thementat/stages/datasheets/Stages.xlsx

Stages, 0805
Index | Qty | Description | Specs | Value | Package | New Mouser | References
SMT parts
R1, R2, R3, R4, R17, R18 | 6 | Resistor | <=1%, 100mW | 15k | 0805 | 603-RC0805FR-0715KL |  | 603-RC0805FR-0715KL|6
R5, R7, R8, R9, R10, R11 | 6 | Resistor | <=1%, 100mW | 100 | 0805 | 603-RC0805FR-07100RL |  | 603-RC0805FR-07100RL|6
R6, R12, R33, R60, R61, R62, R63, R64, R65 | 9 | Resistor | <=1%, 100mW | 10k | 0805 | 603-RC0805FR-0710KL |  | 603-RC0805FR-0710KL|9
R13, R14, R15, R16, R19, R20, R47, R49, R50, R51, R52, R53 | 12 | Resistor | <=1%, 100mW | 20k | 0805 | 603-RC0805FR-0720KL |  | 603-RC0805FR-0720KL|12
R21, R22, R23, R24, R26, R29 | 6 | Resistor | <=1%, 100mW | 30k | 0805 | 603-RC0805FR-0730KL |  | 603-RC0805FR-0730KL|6
R25, R27, R28, R30, R31, R32, R48, R66, R67, R68, R69, R70, R71, R72, R73, R74, R75, R76, R77 | 19 | Resistor | <=1%, 100mW | 100k | 0805 | 603-RC0805FR-07100KL |  | 603-RC0805FR-07100KL|19
R34, R35, R36, R37, R38, R39, R54, R55, R56, R57, R58, R59 | 12 | Resistor | <= 1%, >= 200mW | 1.0k | 0805 | 603-RC0805FR-071KL |  | 603-RC0805FR-071KL|12
R40, R41, R42, R43, R44, R45, R46 | 7 | Resistor | <=1%, 100mW | 130k | 0805 | 603-RC0805FR-07130KL |  | 603-RC0805FR-07130KL|7
L1, L2, L4, L5 | 4 | EMI Filter Bead | >= 1k ohm, 300mA |  | 0805 | 810-MMZ2012S102A | Würth Electronics 742792664 | 810-MMZ2012S102A|4
L3 | 1 | Inductor |  | 33u | 0805 | 810-MLZ2012M330WT000 | TDK MLZ2012M330WT000 | 810-MLZ2012M330WT000|1
C1, C2, C5, C6, C9, C10, C17, C19, C20, C21, C22, C23, C25 | 13 | Capacitor, ceramic | >= 25V, X5R | 22u | 1206 | 963-TMK316BBJ226ML-T | Murata GRM31CR61E226ME15L | 963-TMK316BBJ226ML-T|13
C3, C4 | 2 | Capacitor, ceramic | >=25V, C0G, <= 5% | 20p | 0805 | 603-CC805JRNPO9BN200 | Murata GRM1555C1E200JA01D | 603-CC805JRNPO9BN200|2
C7, C8, C11, C13, C14, C15, C16, C24, C30, C33, C34, C50, C51, C52, C53, C54, C55 | 17 | Capacitor, ceramic | >= 25V, X5R | 100n | 0805 | 581-08053D104KAT2A | Murata GRM155R61E104KA87D | 581-08053D104KAT2A|17
C12, C18, C26, C41, C43 | 5 | Capacitor, ceramic | >= 25V, X6S | 1u | 0805 | 81-GRM219C8YA105KA3D | Murata GRM155C81E105ME11D | 81-GRM219C8YA105KA3D|5
C27, C29, C31, C32, C35 | 5 | Capacitor, ceramic | >= 25V, X7R, <= 5% | 2.2n | 0805 | 603-CC805JRX7R9BB222 | Murata GRM155R71H222JA01J | 603-CC805JRX7R9BB222|5
C28 | 1 | Capacitor, ceramic | >= 25V, C0G, <= 5% | 470p | 0805 | 80-C0805C471J1GAUTO | Murata GRM1555C1E471JA01D | 80-C0805C471J1GAUTO|1
C36, C37, C38, C39, C40, C42 | 6 | Ceradiode |  |  | 0805 | 810-AVR-M2012C220K | Epcos / TDK B72500D160H60 | 810-AVR-M2012C220K|6
C44, C45, C46, C47, C48, C49 | 6 | Capacitor, ceramic | >= 25V, C0G, <= 5% | 100p | 0805 | 810-CGJ4C2C0G2A101J | Murata GRM1555C1H101JA01D | 810-CGJ4C2C0G2A101J|6
D1, D2 | 2 | 1N5819HW diode |  |  | SOD123 | 621-1N5819HW-F | Diodes Inc 1N5819HW-7-F | 621-1N5819HW-F|2
D3, D4, D5, D6, D7, D8 | 6 | 1N4148 silicon diode |  |  | SOD123 | 1N4148WQ-7-F | Fairchild Semi 1N4148WT | 1N4148WQ-7-F|6
D9 | 1 | BAT54S diode |  |  | SOT23 | 512-BAT54S | Fairchild BAT54S | 512-BAT54S|1
IC1 | 1 | TLC59281DBQ 16ch LED driver |  |  | TSSOP24 | 595-TLC59281DBQR | Texas Instruments TLC59281DBQR | 595-TLC59281DBQR|1
IC2 | 1 | ROF-78E3.3-0.5SMD-R 3.3V DC/DC converter |  |  | 12.5mm x 13.5mm | 919-ROF78E3.3-.5SMDR |  | 919-ROF78E3.3-.5SMDR|1
IC3, IC6 | 2 | CD4051 8-1 multiplexer |  |  | TSSOP16 | 595-CD4051BPWR |  | 595-CD4051BPWR|2
IC4 | 1 | DAC8168 octal DAC 14-bit |  |  | TSSOP14 | 595-DAC8168IAPW | Texas Instruments DAC8168IAPW | 595-DAC8168IAPW|1
IC5 | 1 | STM32F373RBT6, Cortex M4 128k flash |  |  | LQFP64 | 511-STM32F373RBT6 | ST STM32F373RBT6 | 511-STM32F373RBT6|1
IC7 | 1 | LD2981ABU33 LDO regulator | 3.3V |  | SOT89-3 | 511-LD2981ABU33 | ST LD2981ABU33TR | 511-LD2981ABU33|1
IC8, IC9, IC10 | 3 | MCP6002 dual op-amp R2R IO |  |  | MSOP8 | 579-MCP6002T-I/MS | Microchip MCP6002T-I/MS | 579-MCP6002T-I/MS|3
IC11 | 1 | LM4040 Shunt Vref | C Grade | 2.5V | SOT23 | 595-LM4040C25IDBZR | Texas Instruments LM4040C25IDBZ | 595-LM4040C25IDBZR|1
IC12, IC13, IC14 | 3 | TL074 Quad op-amp |  |  | TSSOP14 | 595-TL074CPWR |  | 595-TL074CPWR|3
Q1 | 1 | Crystal | <= 20ppm | 8MHz | 6mm x 3.6mm | 815-ABMM2-8-E2T | Abracon ABMM2-8.000MHZ-E2-T | 815-ABMM2-8-E2T|1
Q2, Q3, Q4, Q5, Q6, Q7 | 6 | NPN transistor MMBT3904 |  |  | SOT23 | 863-MMBT3904LT1G | On Semi MMBT3904LT1G | 863-MMBT3904LT1G|6
SMT parts (hand-soldered)
JP5 | 1 | 2x5 Header, 2.54 pitch
PTH parts, top side
JP3, JP4 | 2 | 1x3 male header, 2.54mm pitch
PTH parts, bottom side
J1, J2, J3, J4, J5, J6, J7, J8, J9, J10, J11, J12, J13, J14, J15, J16, J17, J18 | 18 | Vertical jack connector |  |  |  |  | https://www.thonk.co.uk/shop/thonkiconn/
LED1, LED2, LED3, LED4, LED5, LED6 | 6 | LED, Red/Green, 2 terminals |  |  | 2 terminals | 604-WP937EGW |  | 604-WP937EGW|6
- | 6 | LED holder, 10mm |  |  |  |  | Multicomp LED3-10
LED7, LED8, LED9, LED10, LED11, LED12 | 6 | LED 3mm red/green common anode |  |  |  | 696-SSLLX3059IGWCA | Lumex SSL-LX3059IGW-CA | 696-SSLLX3059IGWCA|6
- | 6 | LED holder, 0.3in |  |  |  | 749-ERM1-300 | Bivar ERM 1-300
R78, R79, R80, R81, R82, R83 | 6 | 20k linear slide pot, green LED |  |  |  | 652-PTL20-15G1-203B2 | Bourns PTL20-15G1-203B2 | 652-PTL20-15G1-203B2|6
R84, R85, R86, R87, R88, R89 | 6 | 10k linear pot, 25mm shaft with marker |  |  |  |  | https://www.thonk.co.uk/shop/ttpots/
SW1, SW2, SW3, SW4, SW5, SW6 | 6 | Switch, 6mm |  |  |  | 612-TL1105SP-250 | E-switch TL1105SPF250Q | 612-TL1105SP-250|6
- | 6 | Cap for switch |  |  |  | 612-1R-BK | E-switch 1RBLK | 612-1R-BK|6
PCB |  | 69.2 x 106.7
