thementat/stages/(list of files, cad)

Other CAD files:
pdf/stages_v70_panel.dwg
