thementat/stages/pdf/Schematic.pdf

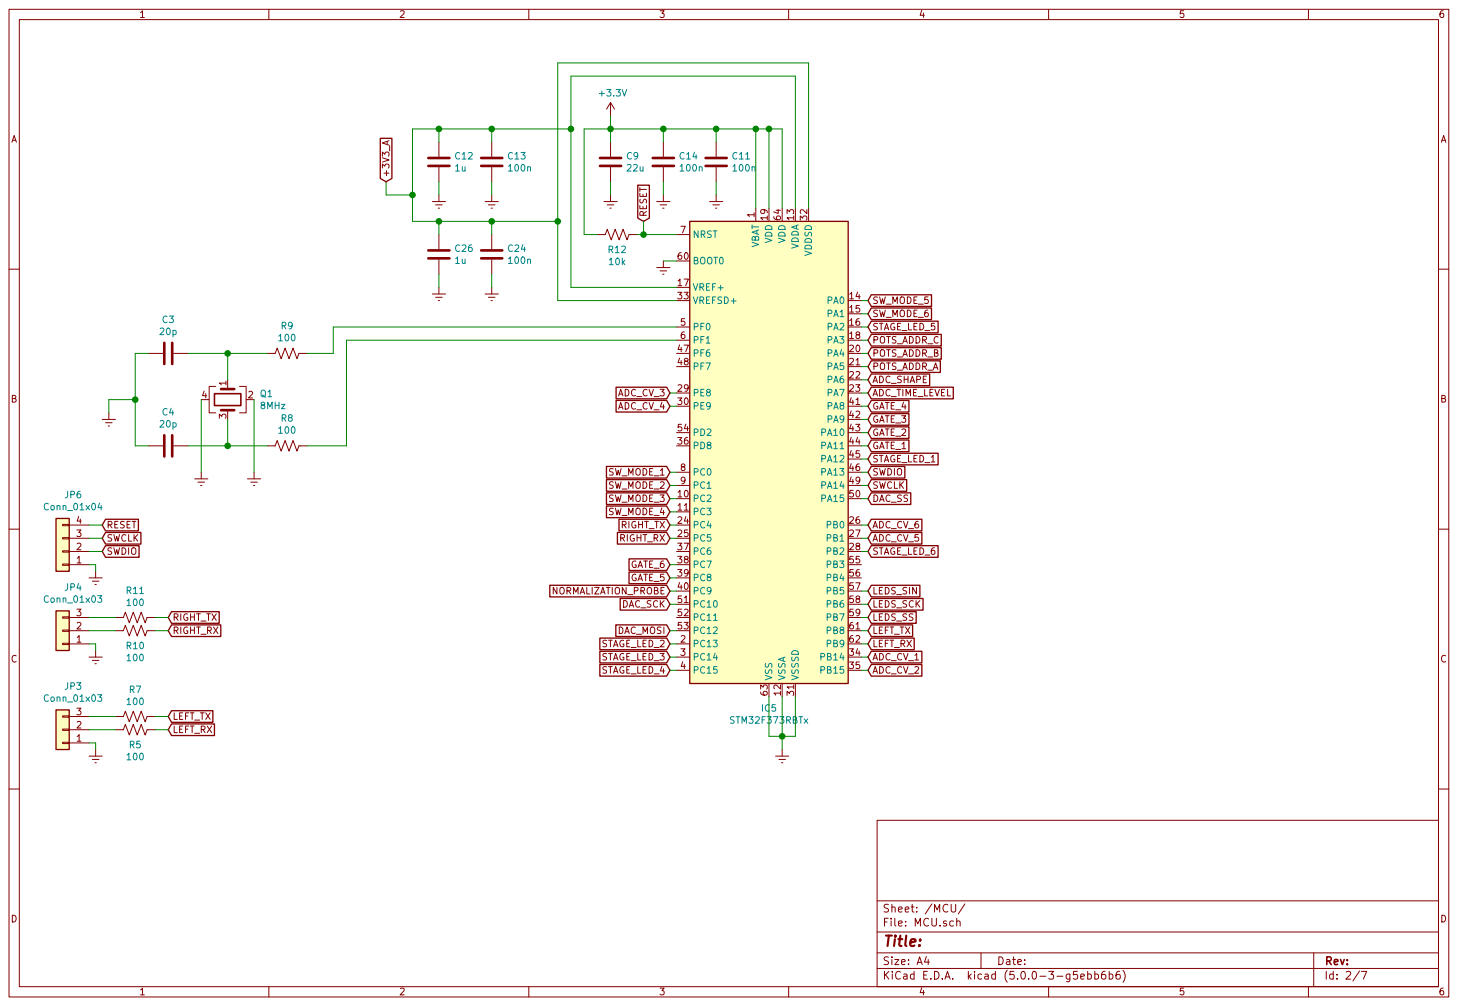
[picture p1: page 1]

Id: 2/7 Title: File: MCU.sch Sheet: /MCU/

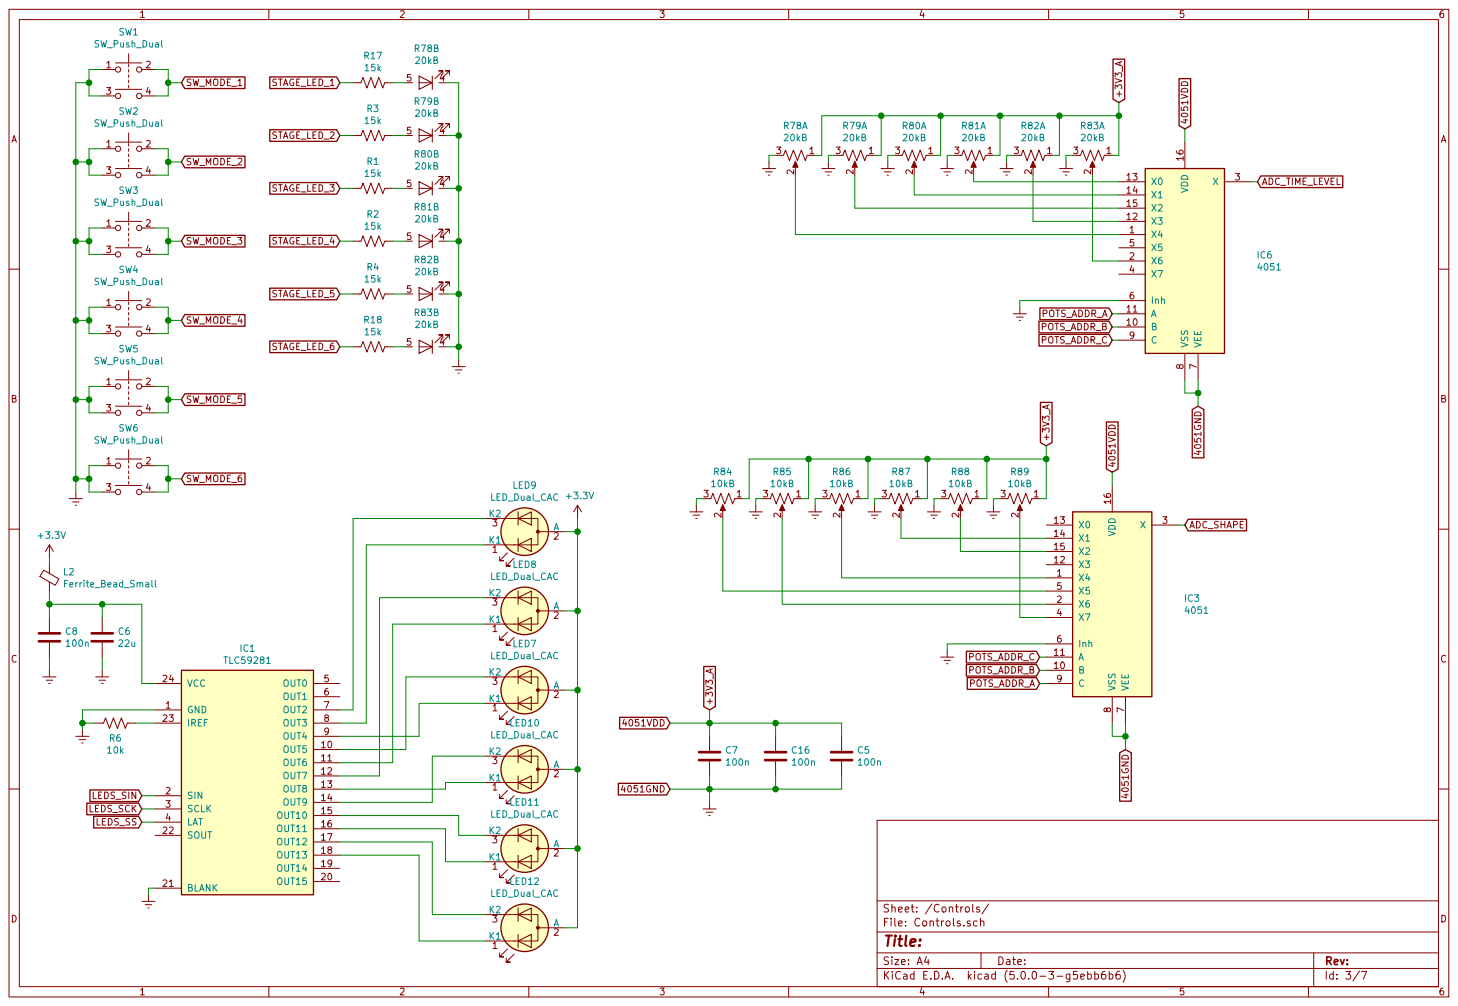
[picture p2: page 2]

Id: 3/7 Title: File: Controls.sch Sheet: /Controls/ 1 2 3 R78A

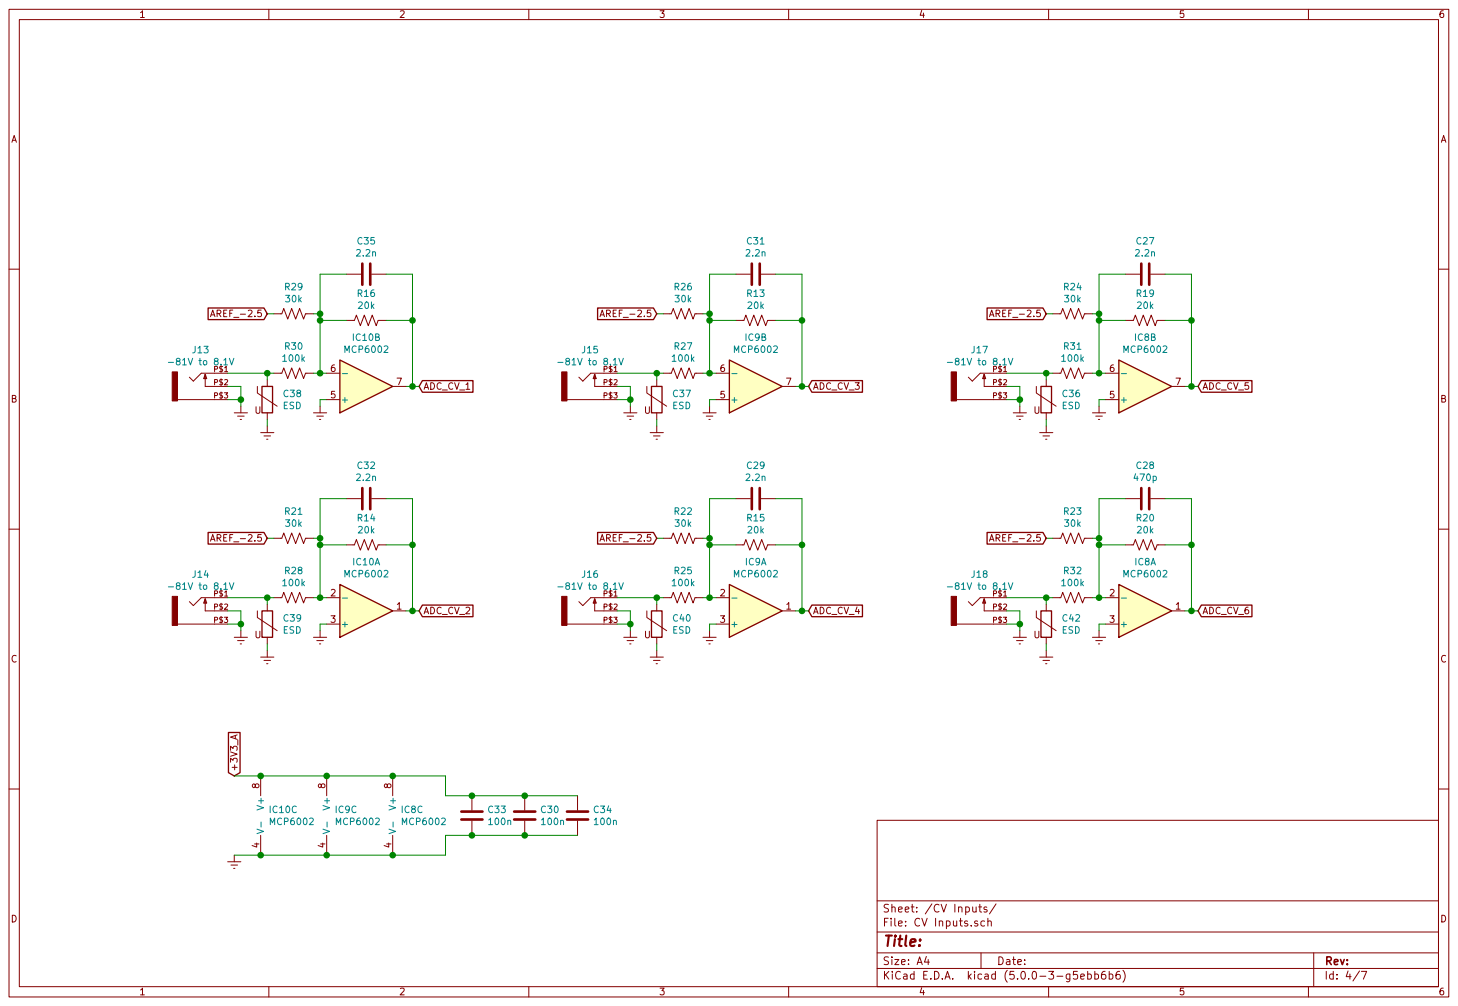
[picture p3: page 3]

File: CV Inputs.sch
Id: 4/7 Title:

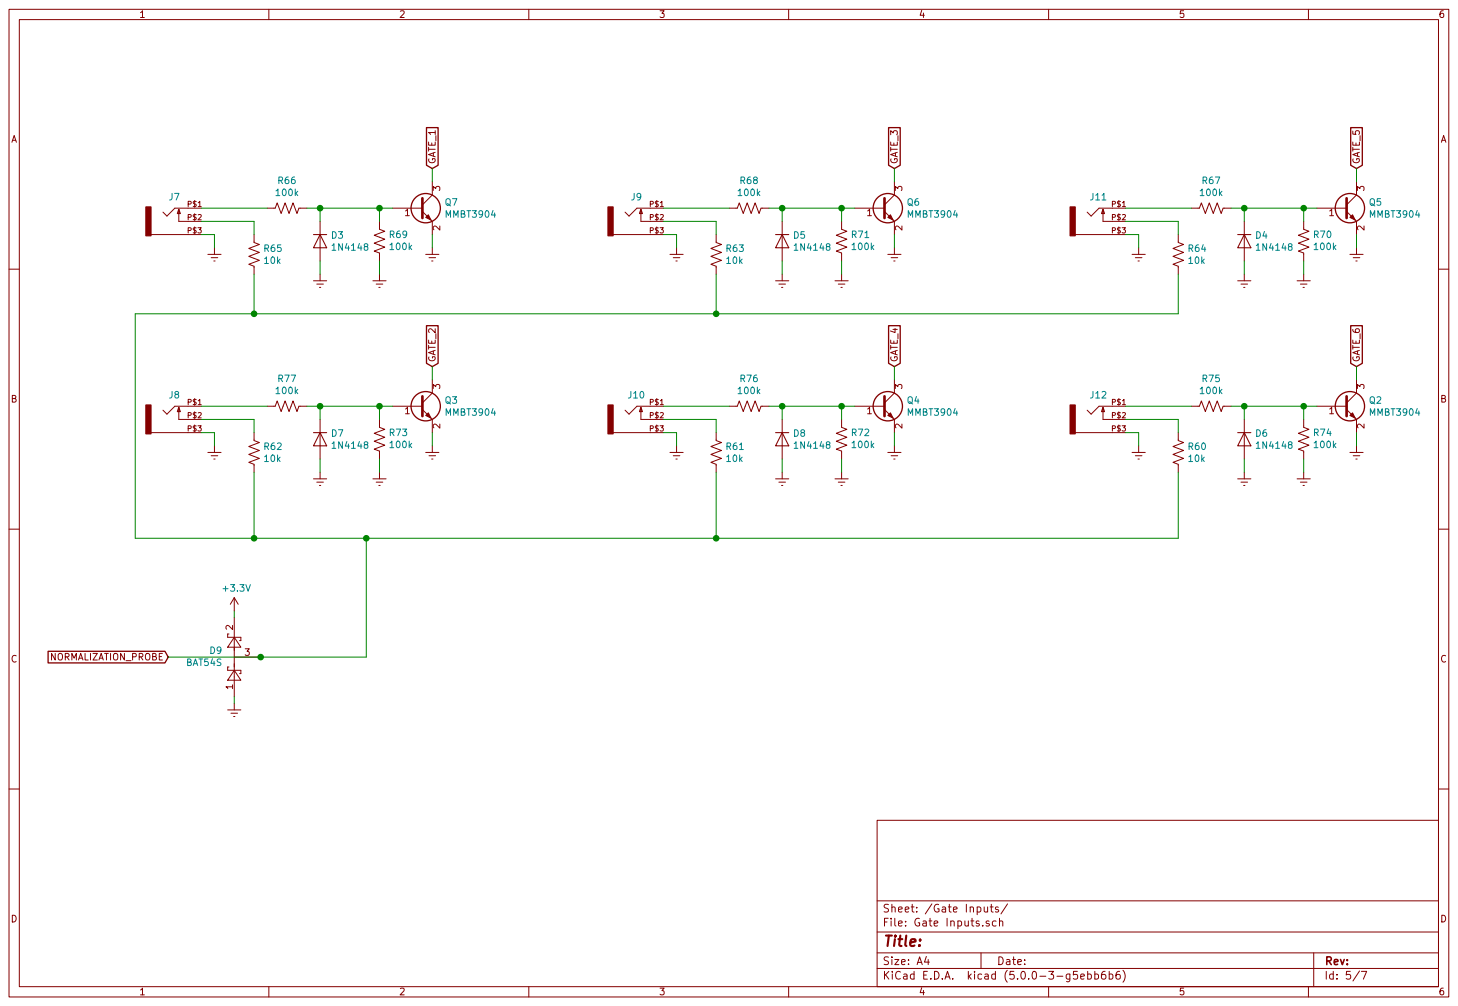
[picture p4: page 4]

Sheet: /Gate Inputs/
File: Gate Inputs.sch
Id: 5/7 Title:

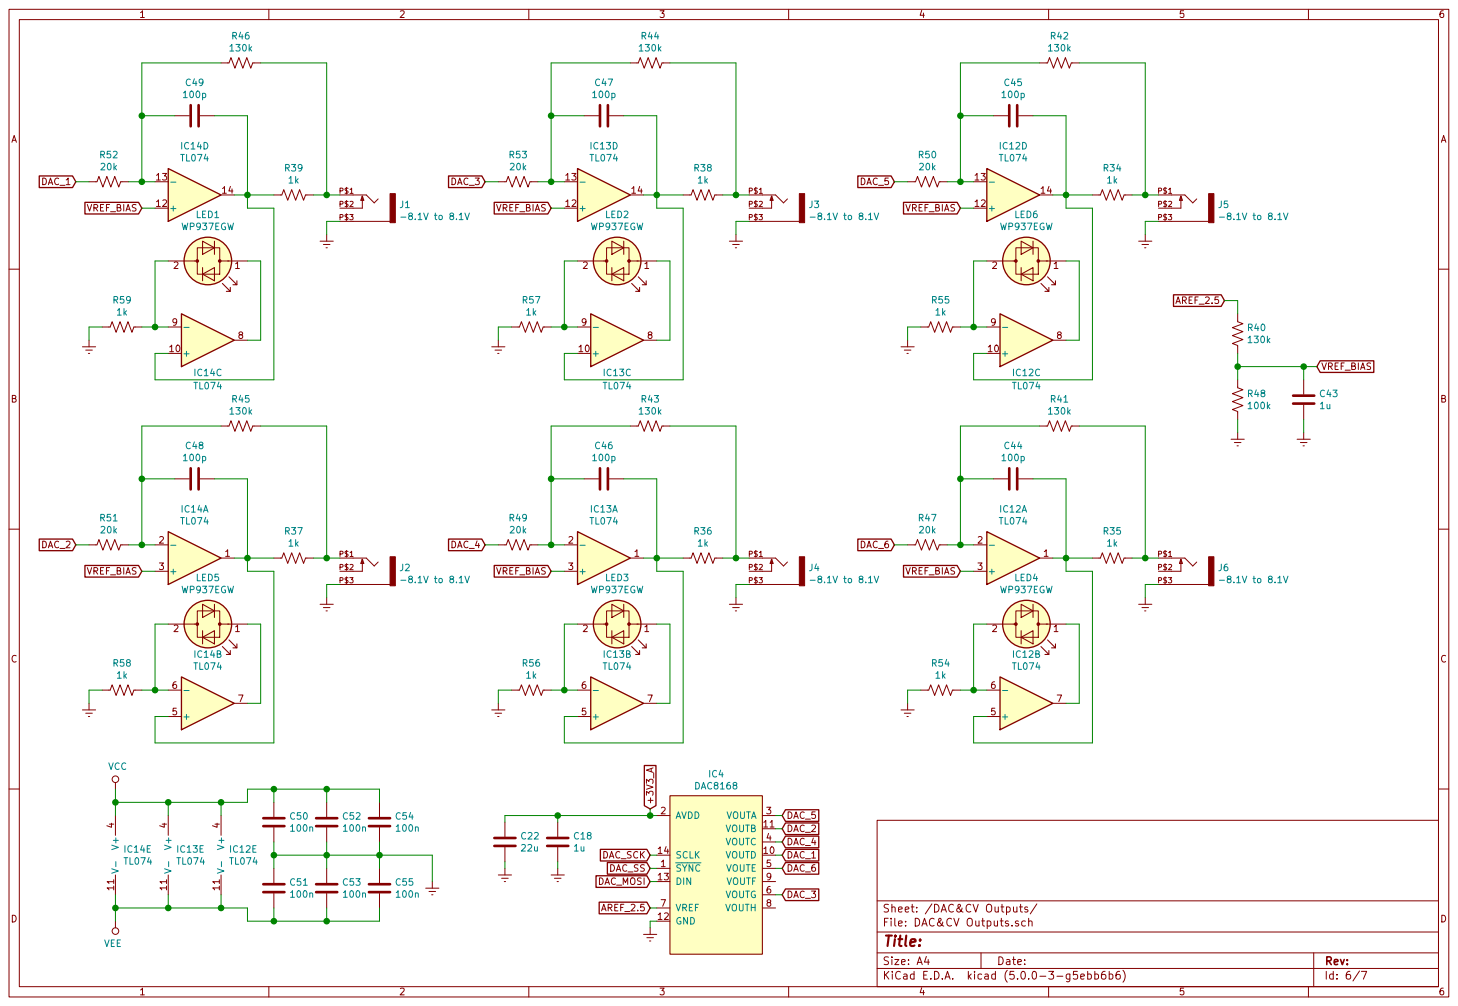
[picture p5: page 5]

Sheet: /DAC&CV Outputs/
File: DAC&CV Outputs.sch
Id: 6/7 Title:

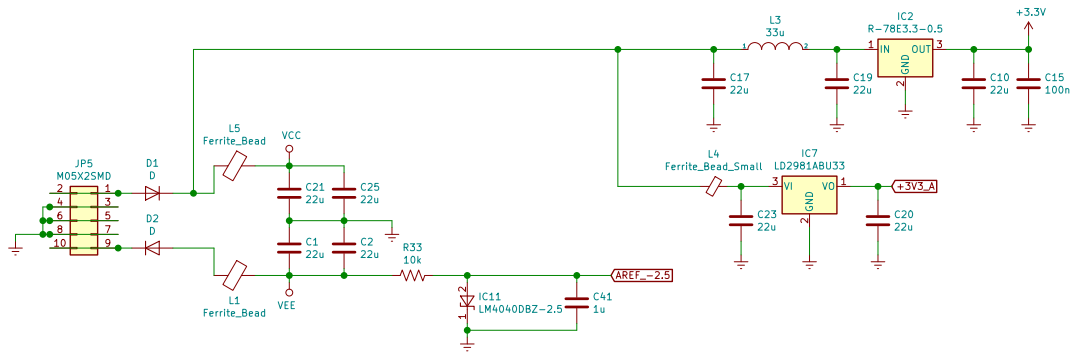
[picture p6: page 6]

Id: 7/7 Title: File: Power.sch Sheet: /Power/
