thementat/stages/pdf/Power-Power.pdf

Id: 7/7 Title: File: Power.sch Sheet: /Power/
