thementat/stages/pdf/Stages.pdf

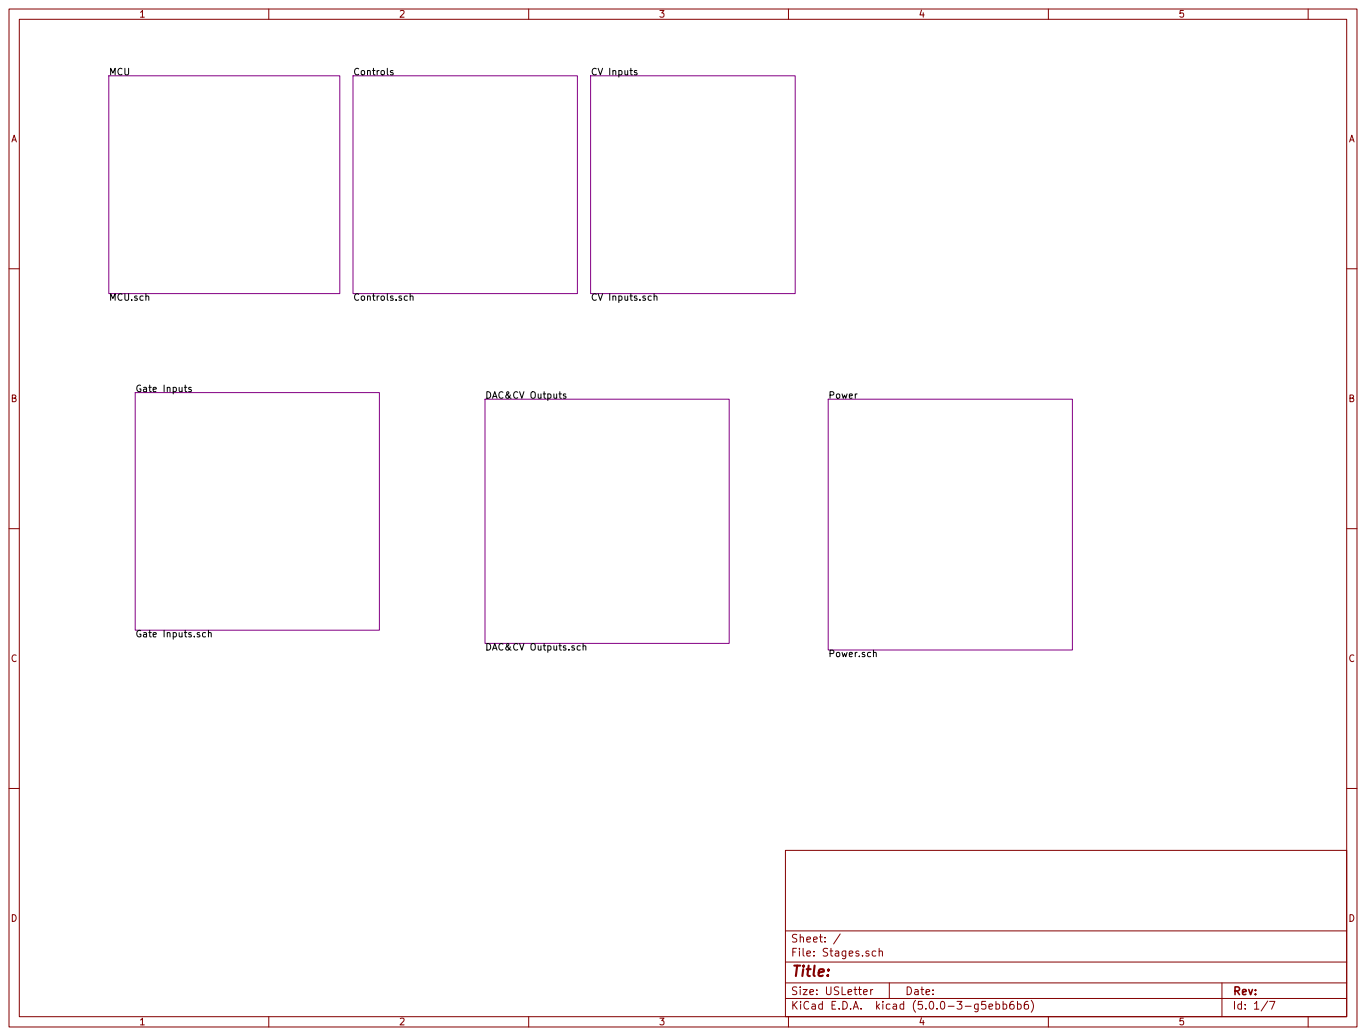
[picture p7: page 1]

File: Stages.sch Sheet: /


Id: 2/7 Title: File: MCU.sch Sheet: /MCU/


Id: 3/7 Title: File: Controls.sch Sheet: /Controls/ 1 2 3 R78A


File: CV Inputs.sch
Id: 4/7 Title:


Sheet: /Gate Inputs/
File: Gate Inputs.sch
Id: 5/7 Title:


Sheet: /DAC&CV Outputs/
File: DAC&CV Outputs.sch
Id: 6/7 Title:


Id: 7/7 Title: File: Power.sch Sheet: /Power/
