thementat/stages/pdf/stages_v70_panel.pdf

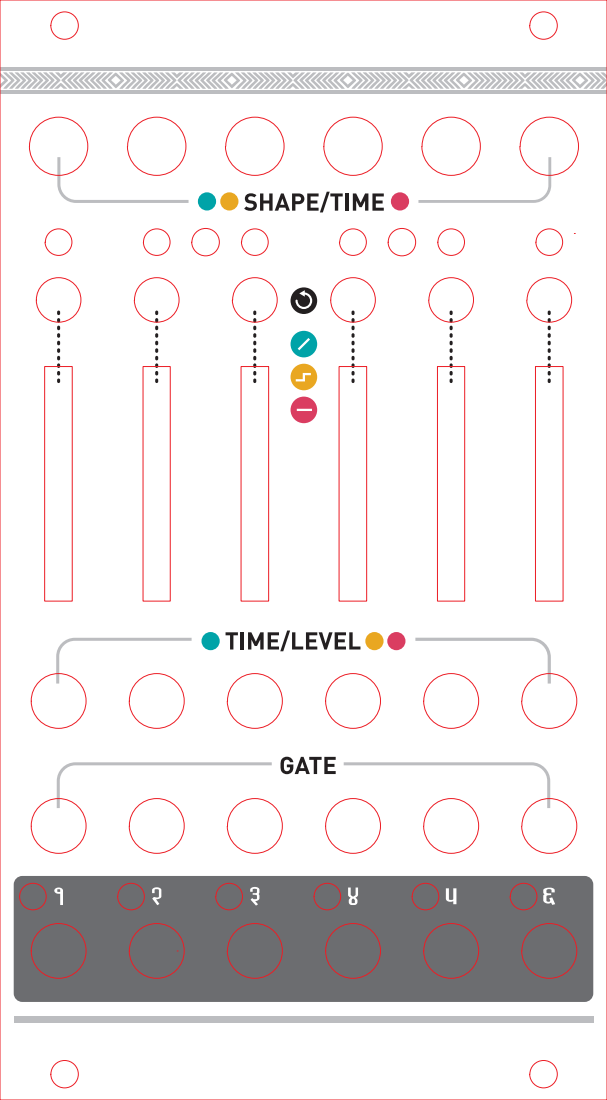
[picture p8: page 1]
