thementat/stages/pdf/Controls-Controls.pdf

Id: 3/7 Title: File: Controls.sch Sheet: /Controls/ 1 2 3 R78A
