thementat/stages/pdf/CV Inputs-CV Inputs.pdf

File: CV Inputs.sch
Id: 4/7 Title:
