thementat/stages/pdf/DAC&CV Outputs-DAC&CV Outputs.pdf

Sheet: /DAC&CV Outputs/
File: DAC&CV Outputs.sch
Id: 6/7 Title:
