thementat/stages/pdf/Gate Inputs-Gate Inputs.pdf

Sheet: /Gate Inputs/
File: Gate Inputs.sch
Id: 5/7 Title:
