thementat/stages/pdf/MCU-MCU.pdf

Id: 2/7 Title: File: MCU.sch Sheet: /MCU/
