thementat/stages/pdf/Panel Holes.pdf

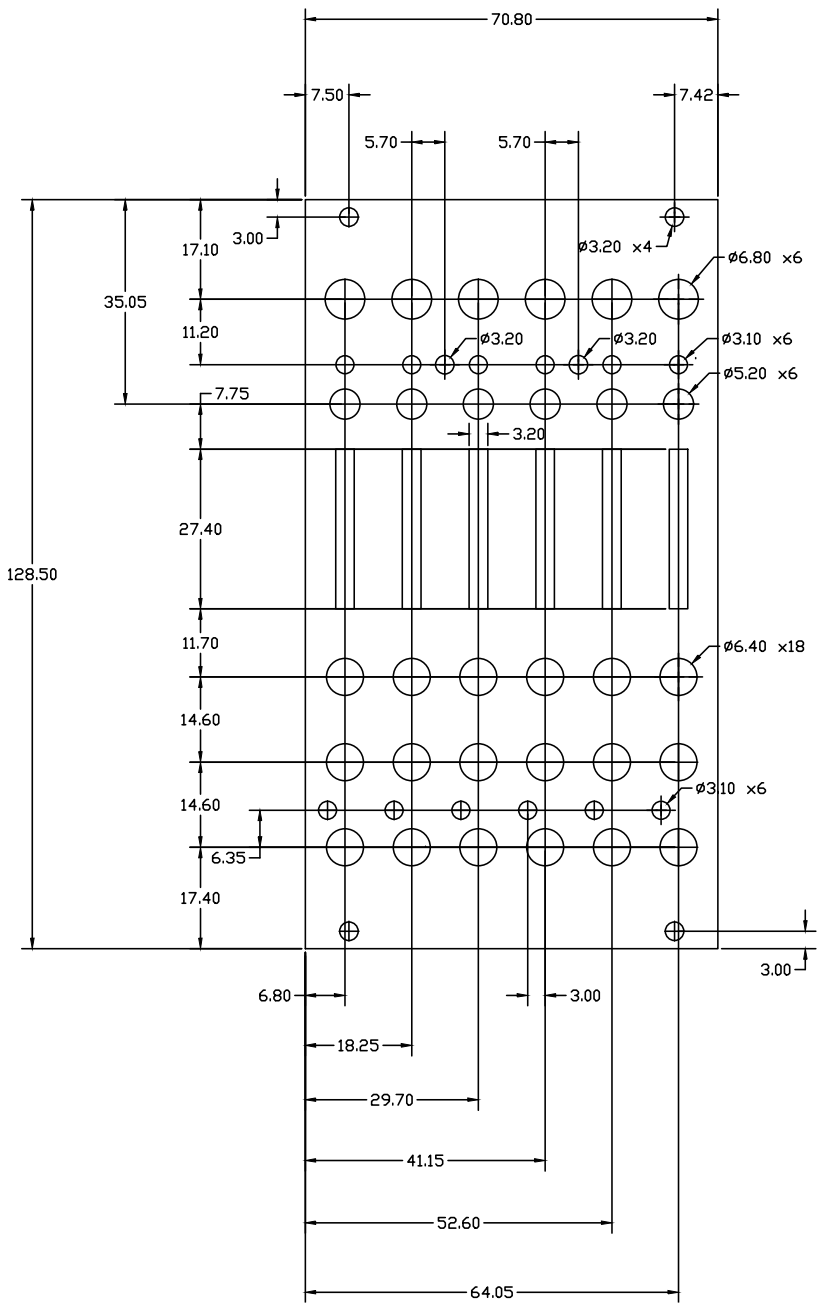
[picture p9: page 1]
