thementat/stages/Stages.kicad_pcb

## KiCad design Stages.kicad_pcb (2019-01-02)

Schematic: MCU.sch

Parts:
C3, C4: 20p; C_0805_2012Metric
C9: 22u; C_1206_3216Metric
C11, C13, C14, C24: 100n; C_0805_2012Metric
C12, C26: 1u; C_0805_2012Metric
IC5: STM32F373RBTx; LQFP-64_10x10mm_P0.5mm
JP3, JP4: Conn_01x03; PinHeader_1x03_P2.54mm_Vertical
JP6: Conn_01x04; PinHeader_1x04_P2.54mm_Vertical
Q1: 8MHz; Crystal_SMD_Abracon_ABMM2-4Pin_6.0x3.6mm_HandSoldering
R5, R7, R8, R9, R10, R11: 100; R_0805_2012Metric
R12: 10k; R_0805_2012Metric

Connections:
+3V3: C9.1, C11.1, C14.1, IC5.1 (VBAT), IC5.19 (VDD), IC5.64 (VDD), R12.2; also elsewhere on the board
+3V3_A: C12.1, C13.1, C24.1, C26.1, IC5.13 (VDDA), IC5.17 (VREF+), IC5.32 (VDDSD), IC5.33 (VREFSD+); also elsewhere on the board
ADC_CV_1: IC5.34 (PB14); also elsewhere on the board
ADC_CV_2: IC5.35 (PB15); also elsewhere on the board
ADC_CV_3: IC5.29 (PE8); also elsewhere on the board
ADC_CV_4: IC5.30 (PE9); also elsewhere on the board
ADC_CV_5: IC5.27 (PB1); also elsewhere on the board
ADC_CV_6: IC5.26 (PB0); also elsewhere on the board
ADC_SHAPE: IC5.22 (PA6); also elsewhere on the board
ADC_TIME_LEVEL: IC5.23 (PA7); also elsewhere on the board
DAC_MOSI: IC5.53 (PC12); also elsewhere on the board
DAC_SCK: IC5.51 (PC10); also elsewhere on the board
DAC_SS: IC5.50 (PA15); also elsewhere on the board
GATE_1: IC5.44 (PA11); also elsewhere on the board
GATE_2: IC5.43 (PA10); also elsewhere on the board
GATE_3: IC5.42 (PA9); also elsewhere on the board
GATE_4: IC5.41 (PA8); also elsewhere on the board
GATE_5: IC5.39 (PC8); also elsewhere on the board
GATE_6: IC5.38 (PC7); also elsewhere on the board
LEDS_SCK: IC5.58 (PB6); also elsewhere on the board
LEDS_SIN: IC5.57 (PB5); also elsewhere on the board
LEDS_SS: IC5.59 (PB7); also elsewhere on the board
LEFT_RX: IC5.62 (PB9), R7.1
LEFT_TX: IC5.61 (PB8), R5.1
NORMALIZATION_PROBE: IC5.40 (PC9); also elsewhere on the board
unnamed: C3.2, Q1.1, R9.1
unnamed: C4.2, Q1.3, R8.1
unnamed: IC5.5 (PF0), R9.2
unnamed: IC5.6 (PF1), R8.2
unnamed: JP3.2, R5.2
unnamed: JP3.3, R7.2
unnamed: JP4.2, R10.2
unnamed: JP4.3, R11.2
POTS_ADDR_A: IC5.21 (PA5); also elsewhere on the board
POTS_ADDR_B: IC5.20 (PA4); also elsewhere on the board
POTS_ADDR_C: IC5.18 (PA3); also elsewhere on the board
RESET: IC5.7 (NRST), JP6.4, R12.1
RIGHT_RX: IC5.25 (PC5), R10.1
RIGHT_TX: IC5.24 (PC4), R11.1
STAGE_LED_1: IC5.45 (PA12); also elsewhere on the board
STAGE_LED_2: IC5.2 (PC13); also elsewhere on the board
STAGE_LED_3: IC5.3 (PC14); also elsewhere on the board
STAGE_LED_4: IC5.4 (PC15); also elsewhere on the board
STAGE_LED_5: IC5.16 (PA2); also elsewhere on the board
STAGE_LED_6: IC5.28 (PB2); also elsewhere on the board
SWCLK: IC5.49 (PA14), JP6.3
SWDIO: IC5.46 (PA13), JP6.2
SW_MODE_1: IC5.8 (PC0); also elsewhere on the board
SW_MODE_2: IC5.9 (PC1); also elsewhere on the board
SW_MODE_3: IC5.10 (PC2); also elsewhere on the board
SW_MODE_4: IC5.11 (PC3); also elsewhere on the board
SW_MODE_5: IC5.14 (PA0); also elsewhere on the board
SW_MODE_6: IC5.15 (PA1); also elsewhere on the board

Schematic: Controls.sch

Parts:
C5, C7, C8, C16: 100n; C_0805_2012Metric
C6: 22u; C_1206_3216Metric
IC1: TLC59281; TSSOP-24_4.4x7.8mm_P0.65mm
IC3, IC6: 4051; TSSOP-16_4.4x5mm_P0.65mm
L2: Ferrite_Bead_Small; R_0805_2012Metric
LED7, LED8, LED9, LED10, LED11, LED12: LED_Dual_CAC; LED_3.0mm Bi-Color Common Anode
MH1, MH2, MH3: MountingHole; MountingHole_3.2mm_M3
R1, R2, R3, R4, R17, R18: 15k; R_0805_2012Metric
R6: 10k; R_0805_2012Metric
R78, R79, R80, R81, R82, R83: 20kB; Potentiometer-Bourns PTL20
R84, R85, R86, R87, R88, R89: 10kB; Potentiometer_SongHuei9mm-1_Single_Vertical
SW1, SW2, SW3, SW4, SW5, SW6: SW_Push_4pin; Push E-Switch 6mm

Connections:
+3V3: L2.1, LED7.2, LED8.2, LED9.2, LED10.2, LED11.2, LED12.2; also elsewhere on the board
+3V3_A: C5.1, C7.1, C16.1, IC3.16, IC6.16, R78.3, R79.3, R80.3, R81.3, R82.3, R83.3, R84.1, R85.1, R86.1, R87.1, R88.1, R89.1; also elsewhere on the board
ADC_SHAPE: IC3.3; also elsewhere on the board
ADC_TIME_LEVEL: IC6.3; also elsewhere on the board
LEDS_SCK: IC1.3; also elsewhere on the board
LEDS_SIN: IC1.2; also elsewhere on the board
LEDS_SS: IC1.4; also elsewhere on the board
unnamed: C6.1, C8.1, IC1.24, L2.2
unnamed: IC1.7, LED9.3
unnamed: IC1.8, LED9.1
unnamed: IC1.9, LED7.1
unnamed: IC1.10, LED7.3
unnamed: IC1.11, LED8.1
unnamed: IC1.12, LED8.3
unnamed: IC1.13, LED10.1
unnamed: IC1.14, LED10.3
unnamed: IC1.15, LED11.3
unnamed: IC1.16, LED11.1
unnamed: IC1.17, LED12.3
unnamed: IC1.18, LED12.1
unnamed: IC1.23, R6.1
unnamed: IC3.1, R86.2
unnamed: IC3.2, R85.2
unnamed: IC3.4, R89.2
unnamed: IC3.5, R84.2
unnamed: IC3.14, R87.2
unnamed: IC3.15, R88.2
unnamed: IC6.1, R78.2
unnamed: IC6.2, R83.2
unnamed: IC6.12, R82.2
unnamed: IC6.13, R81.2
unnamed: IC6.14, R80.2
unnamed: IC6.15, R79.2
unnamed: R1.1, R80.5
unnamed: R2.1, R81.5
unnamed: R3.1, R79.5
unnamed: R4.1, R82.5
unnamed: R17.1, R78.5
unnamed: R18.1, R83.5
POTS_ADDR_A: IC3.9, IC6.11; also elsewhere on the board
POTS_ADDR_B: IC3.10, IC6.10; also elsewhere on the board
POTS_ADDR_C: IC3.11, IC6.9; also elsewhere on the board
STAGE_LED_1: R17.2; also elsewhere on the board
STAGE_LED_2: R3.2; also elsewhere on the board
STAGE_LED_3: R1.2; also elsewhere on the board
STAGE_LED_4: R2.2; also elsewhere on the board
STAGE_LED_5: R4.2; also elsewhere on the board
STAGE_LED_6: R18.2; also elsewhere on the board
SW_MODE_1: SW1.3, SW1.4; also elsewhere on the board
SW_MODE_2: SW2.3, SW2.4; also elsewhere on the board
SW_MODE_3: SW3.3, SW3.4; also elsewhere on the board
SW_MODE_4: SW4.3, SW4.4; also elsewhere on the board
SW_MODE_5: SW5.3, SW5.4; also elsewhere on the board
SW_MODE_6: SW6.3, SW6.4; also elsewhere on the board

Schematic: CV Inputs.sch

Parts:
C27, C29, C31, C32, C35: 2.2n; C_0805_2012Metric
C28: 470p; C_0805_2012Metric
C30, C33, C34: 100n; C_0805_2012Metric
C36, C37, C38, C39, C40, C42: ESD; C_0805_2012Metric
IC8, IC9, IC10: MCP6002; SOIC-8_3.9x4.9mm_P1.27mm
J13, J14, J15, J16, J17, J18: -8.1V to 8.1V; WQP-PJ301M-12_JACK
R13, R14, R15, R16, R19, R20: 20k; R_0805_2012Metric
R21, R22, R23, R24, R26, R29: 30k; R_0805_2012Metric
R25, R27, R28, R30, R31, R32: 100k; R_0805_2012Metric

Connections:
+3V3_A: C30.1, C33.1, C34.1, IC8.8 (V+), IC9.8 (V+), IC10.8 (V+); also elsewhere on the board
ADC_CV_1: C35.1, IC10.7, R16.1; also elsewhere on the board
ADC_CV_2: C32.1, IC10.1, R14.1; also elsewhere on the board
ADC_CV_3: C31.1, IC9.7, R13.1; also elsewhere on the board
ADC_CV_4: C29.1, IC9.1, R15.1; also elsewhere on the board
ADC_CV_5: C27.1, IC8.7, R19.1; also elsewhere on the board
ADC_CV_6: C28.1, IC8.1, R20.1; also elsewhere on the board
AREF_-2.5: R21.2, R22.2, R23.2, R24.2, R26.2, R29.2; also elsewhere on the board
unnamed: C27.2, IC8.6 (-), R19.2, R24.1, R31.1
unnamed: C28.2, IC8.2 (-), R20.2, R23.1, R32.1
unnamed: C29.2, IC9.2 (-), R15.2, R22.1, R25.1
unnamed: C31.2, IC9.6 (-), R13.2, R26.1, R27.1
unnamed: C32.2, IC10.2 (-), R14.2, R21.1, R28.1
unnamed: C35.2, IC10.6 (-), R16.2, R29.1, R30.1
unnamed: C36.1, J17.P$1, R31.2
unnamed: C37.1, J15.P$1, R27.2
unnamed: C38.1, J13.P$1, R30.2
unnamed: C39.1, J14.P$1, R28.2
unnamed: C40.1, J16.P$1, R25.2
unnamed: C42.1, J18.P$1, R32.2

Schematic: Gate Inputs.sch

Parts:
D3, D4, D5, D6, D7, D8: 1N4148; D_SOD-123
D9: BAT54S; SOT-23
J7, J8, J9, J10, J11, J12: WQP-PJ301M-12_JACK
Q2, Q3, Q4, Q5, Q6, Q7: MMBT3904; SOT-23
R60, R61, R62, R63, R64, R65: 10k; R_0805_2012Metric
R66, R67, R68, R69, R70, R71, R72, R73, R74, R75, R76, R77: 100k; R_0805_2012Metric

Connections:
+3V3: D9.2; also elsewhere on the board
GATE_1: Q7.3 (C); also elsewhere on the board
GATE_2: Q3.3 (C); also elsewhere on the board
GATE_3: Q6.3 (C); also elsewhere on the board
GATE_4: Q4.3 (C); also elsewhere on the board
GATE_5: Q5.3 (C); also elsewhere on the board
GATE_6: Q2.3 (C); also elsewhere on the board
NORMALIZATION_PROBE: D9.3, R60.2, R61.2, R62.2, R63.2, R64.2, R65.2; also elsewhere on the board
unnamed: D3.1, Q7.1 (B), R66.2, R69.2
unnamed: D4.1, Q5.1 (B), R67.2, R70.2
unnamed: D5.1, Q6.1 (B), R68.2, R71.2
unnamed: D6.1, Q2.1 (B), R74.2, R75.2
unnamed: D7.1, Q3.1 (B), R73.2, R77.2
unnamed: D8.1, Q4.1 (B), R72.2, R76.2
unnamed: J7.P$1, R66.1
unnamed: J7.P$2, R65.1
unnamed: J8.P$1, R77.1
unnamed: J8.P$2, R62.1
unnamed: J9.P$1, R68.1
unnamed: J9.P$2, R63.1
unnamed: J10.P$1, R76.1
unnamed: J10.P$2, R61.1
unnamed: J11.P$1, R67.1
unnamed: J11.P$2, R64.1
unnamed: J12.P$1, R75.1
unnamed: J12.P$2, R60.1

Schematic: DAC&CV Outputs.sch

Parts:
C18, C43: 1u; C_0805_2012Metric
C22: 22u; C_1206_3216Metric
C44, C45, C46, C47, C48, C49: 100p; C_0805_2012Metric
C50, C51, C52, C53, C54, C55: 100n; C_0805_2012Metric
IC4: DAC8168; TSSOP-14_4.4x5mm_P0.65mm
IC12, IC13, IC14: TL074; TSSOP-14_4.4x5mm_P0.65mm
J1, J2, J3, J4, J5, J6: -8.1V to 8.1V; WQP-PJ301M-12_JACK
LED1, LED2, LED3, LED4, LED5, LED6: WP937EGW; LED_D3.0mm
R34, R35, R36, R37, R38, R39, R54, R55, R56, R57, R58, R59: 1k; R_0805_2012Metric
R40, R41, R42, R43, R44, R45, R46: 130k; R_0805_2012Metric
R47, R49, R50, R51, R52, R53: 20k; R_0805_2012Metric
R48: 100k; R_0805_2012Metric

Connections:
+3V3_A: C18.1, C22.1, IC4.2; also elsewhere on the board
AREF_2.5: IC4.7, R40.1
DAC_1: IC4.10, R52.2
DAC_2: IC4.11, R51.2
DAC_3: IC4.6, R53.2
DAC_4: IC4.4, R49.2
DAC_5: IC4.3, R50.2
DAC_6: IC4.5, R47.2
DAC_MOSI: IC4.13; also elsewhere on the board
DAC_SCK: IC4.14; also elsewhere on the board
DAC_SS: IC4.1; also elsewhere on the board
unnamed: C44.1, IC12.1, IC12.5 (+), R35.2
unnamed: C44.2, IC12.2 (-), R41.2, R47.1
unnamed: C45.1, IC12.10 (+), IC12.14, R34.2
unnamed: C45.2, IC12.13 (-), R42.2, R50.1
unnamed: C46.1, IC13.1, IC13.5 (+), R36.2
unnamed: C46.2, IC13.2 (-), R43.2, R49.1
unnamed: C47.1, IC13.10 (+), IC13.14, R38.2
unnamed: C47.2, IC13.13 (-), R44.2, R53.1
unnamed: C48.1, IC14.1, IC14.5 (+), R37.2
unnamed: C48.2, IC14.2 (-), R45.2, R51.1
unnamed: C49.1, IC14.10 (+), IC14.14, R39.2
unnamed: C49.2, IC14.13 (-), R46.2, R52.1
unnamed: IC12.6 (-), LED4.2, R54.1
unnamed: IC12.7, LED4.1
unnamed: IC12.8, LED6.1
unnamed: IC12.9 (-), LED6.2, R55.1
unnamed: IC13.6 (-), LED3.2, R56.1
unnamed: IC13.7, LED3.1
unnamed: IC13.8, LED2.1
unnamed: IC13.9 (-), LED2.2, R57.1
unnamed: IC14.6 (-), LED5.2, R58.1
unnamed: IC14.7, LED5.1
unnamed: IC14.8, LED1.1
unnamed: IC14.9 (-), LED1.2, R59.1
unnamed: J1.P$1, R39.1, R46.1
unnamed: J2.P$1, R37.1, R45.1
unnamed: J3.P$1, R38.1, R44.1
unnamed: J4.P$1, R36.1, R43.1
unnamed: J5.P$1, R34.1, R42.1
unnamed: J6.P$1, R35.1, R41.1
VCC: C50.1, C52.1, C54.1, IC12.4 (V+), IC13.4 (V+), IC14.4 (V+); also elsewhere on the board
VEE: C51.2, C53.2, C55.2, IC12.11 (V-), IC13.11 (V-), IC14.11 (V-); also elsewhere on the board
VREF_BIAS: C43.1, IC12.3 (+), IC12.12 (+), IC13.3 (+), IC13.12 (+), IC14.3 (+), IC14.12 (+), R40.2, R48.1

Schematic: Power.sch

Parts:
C1, C2, C10, C19, C20, C21, C23, C25: 22u; C_1206_3216Metric
C15: 100n; C_0805_2012Metric
C17: 22u; C_0805_2012Metric
C41: 1u; C_0805_2012Metric
D1, D2: D; D_SOD-123
IC2: R-78E3.3-0.5; Converter_DCDC_RECOM_ROF-78E-0.5_SMD_HandSoldering
IC7: LD2981ABU33; SOT-89-3_Handsoldering
IC11: LM4040DBZ-2.5; SOT-23
JP5: M05X2SMD; PinHeader_2x05_P2.54mm_Vertical_SMD
L1, L5: Ferrite_Bead; R_0805_2012Metric
L3: 33u; L_0805_2012Metric
L4: Ferrite_Bead_Small; R_0805_2012Metric
MH4: MountingHole_Pad; PinHeader_1x01_P1.00mm_Vertical
R33: 10k; R_0805_2012Metric

Connections:
+3V3: C10.1, C15.1, IC2.3 (OUT); also elsewhere on the board
+3V3_A: C20.1, IC7.1; also elsewhere on the board
AREF_-2.5: C41.1, IC11.2 (A), R33.1; also elsewhere on the board
unnamed: C17.1, D2.1, L3.1, L4.2, L5.2
unnamed: C19.1, IC2.1 (IN), L3.2
unnamed: C23.1, IC7.3, L4.1
unnamed: D1.1, JP5.9, JP5.10
unnamed: D1.2, L1.2
unnamed: D2.2, JP5.1, JP5.2
VCC: C21.1, C25.1, L5.1; also elsewhere on the board
VEE: C1.2, C2.2, L1.1, R33.2; also elsewhere on the board

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
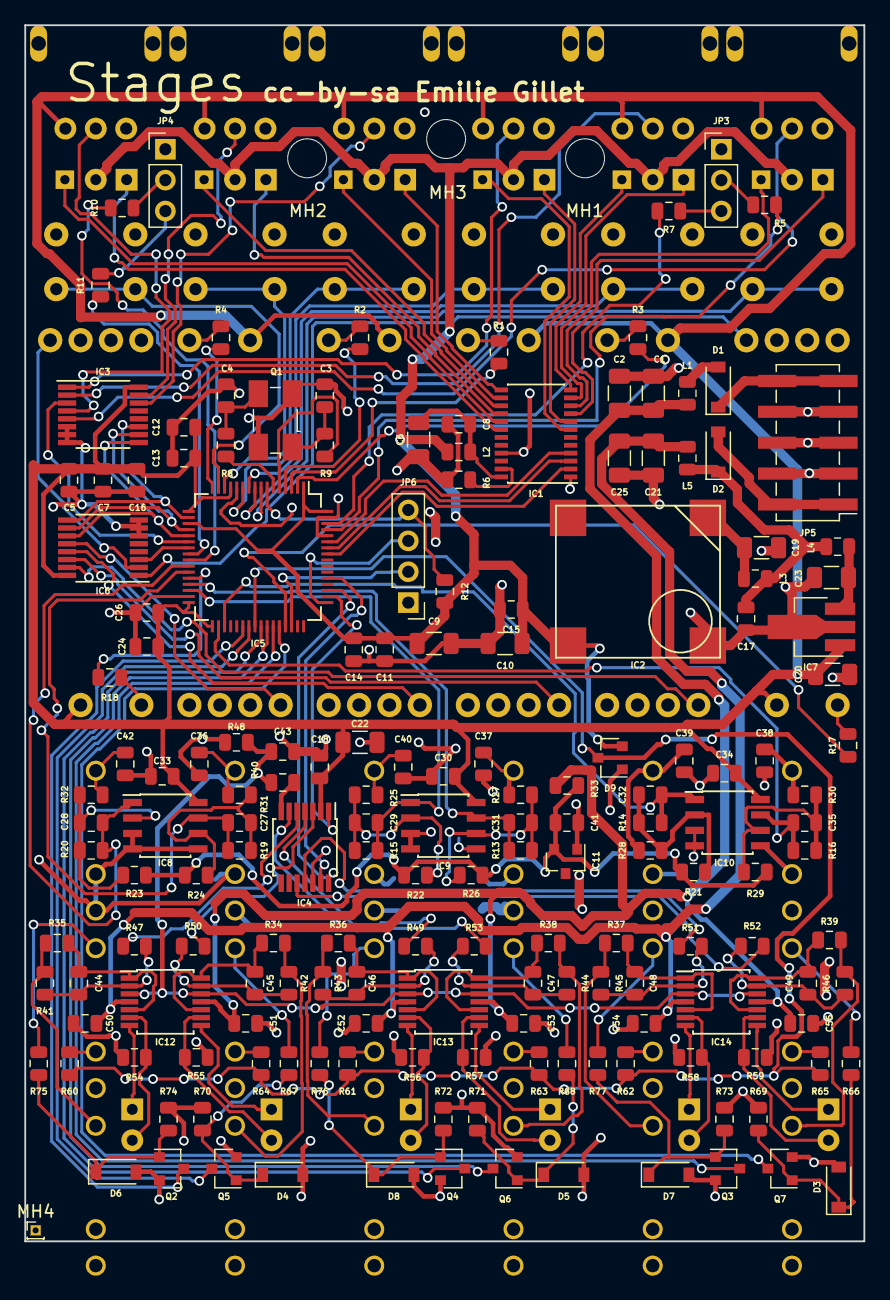
[picture p10: board Stages.kicad_pcb from above]

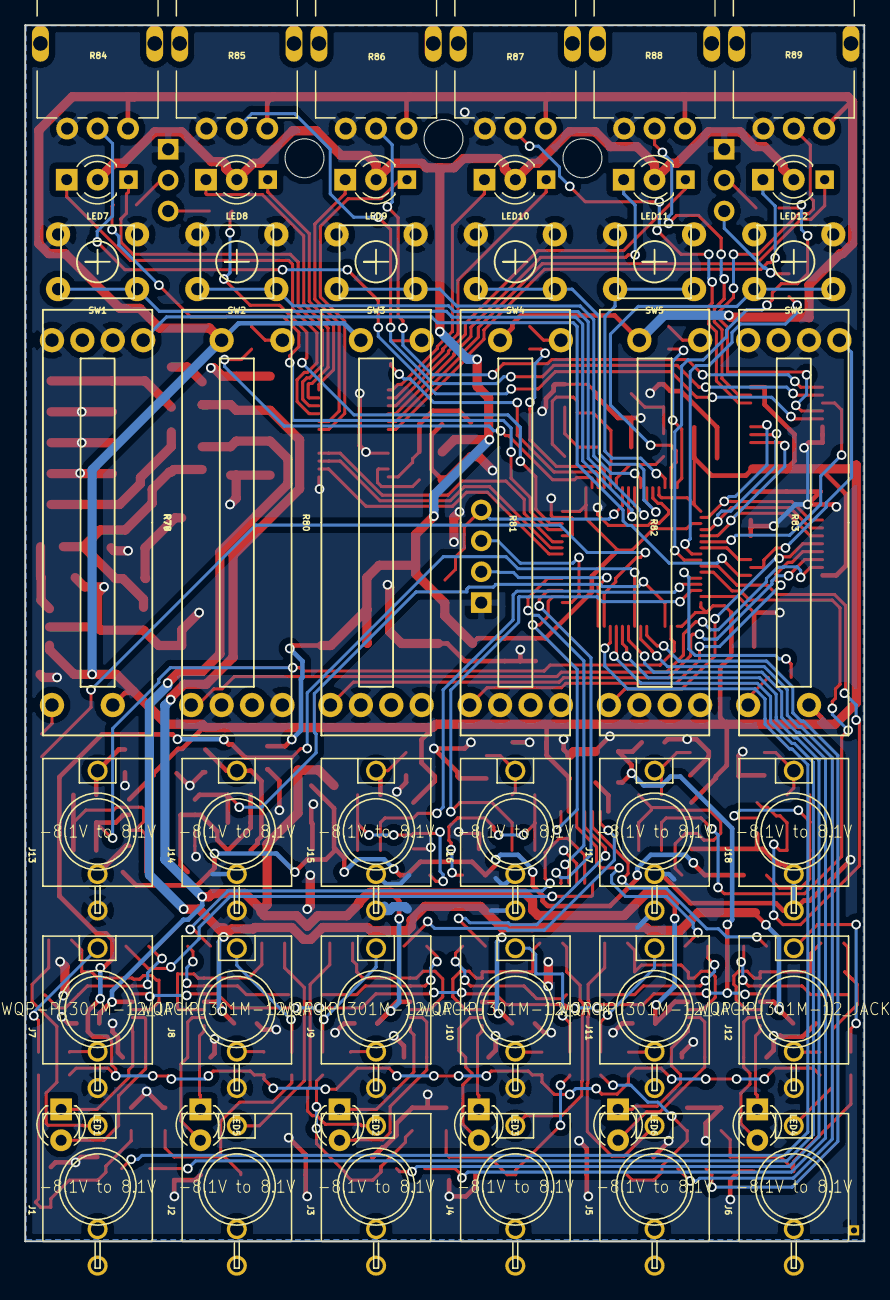
[picture p11: board Stages.kicad_pcb from below]

Board: 2 copper layers, 69.0 x 100.0 mm, 223 parts (48 on the bottom side), 163 nets.
