thementat/stages/(commit log)

2018-12-06 Initial Add
    [CV Inputs.sch, Controls.sch, DAC&CV Outputs.sch, Gate Inputs.sch, MCU.sch, Power.sch, Stages.kicad_pcb, Stages.sch]
2018-12-11 Rough Placement Completed
    Completed the rough placement of the components on the pcb
    [CV Inputs.sch, Gate Inputs.sch, Stages.kicad_pcb, Stages.xlsx]
2018-12-13 Progress on routing tracks
    Most of the power tracks are routed
    [CV Inputs.sch, Controls.sch, DAC&CV Outputs.sch, Gate Inputs.sch, MCU.sch, Power.sch, Stages.kicad_pcb]
2018-12-18 Re-oriented several components
    [Stages.kicad_pcb]
2018-12-19 Re-orientation
    Fixed some bad op-amp orientations
    [DAC&CV Outputs.sch, Stages.kicad_pcb]
2018-12-23 Added Mounting Holes
    [CV Inputs.sch, Controls.sch, MCU.sch, Power.sch, Stages.kicad_pcb]
2018-12-24 Routing Complete
    time to tidy up connections
    [Coordinates.xlsx, Stages.kicad_pcb]
2018-12-27 DRC Complete
    [Stages.kicad_pcb]
2018-12-27 Removed to plane and re-routed
    [Stages.kicad_pcb]
2018-12-27 Tidy up Ground outes
    [Stages.kicad_pcb]
2019-01-01 Fixed Component pinouts
    [Controls.sch, Power.sch, Stages.kicad_pcb]
2019-01-02 Submitted Design
    [Stages-B.Cu.gbr, Stages-B.Mask.gbr, Stages-B.Paste.gbr, Stages-B.SilkS.gbr, Stages-Edge.Cuts.gbr, Stages-F.Cu.gbr, Stages-F.Mask.gbr, Stages-F.Paste.gbr]
2019-02-18 Initial Conversion
    [Board BOM.xlsx, Stages.xlsx, stages_v70_panel.dwg]
2019-03-17 BOM update
    [Stages.xlsx]
