thementat/stages/(notices)

Notices in the files:
Stages.kicad_pcb:
cc-by-sa Emilie Gillet
